JedS/openflight/session_logs/kld7_capture_20260329_095614.png

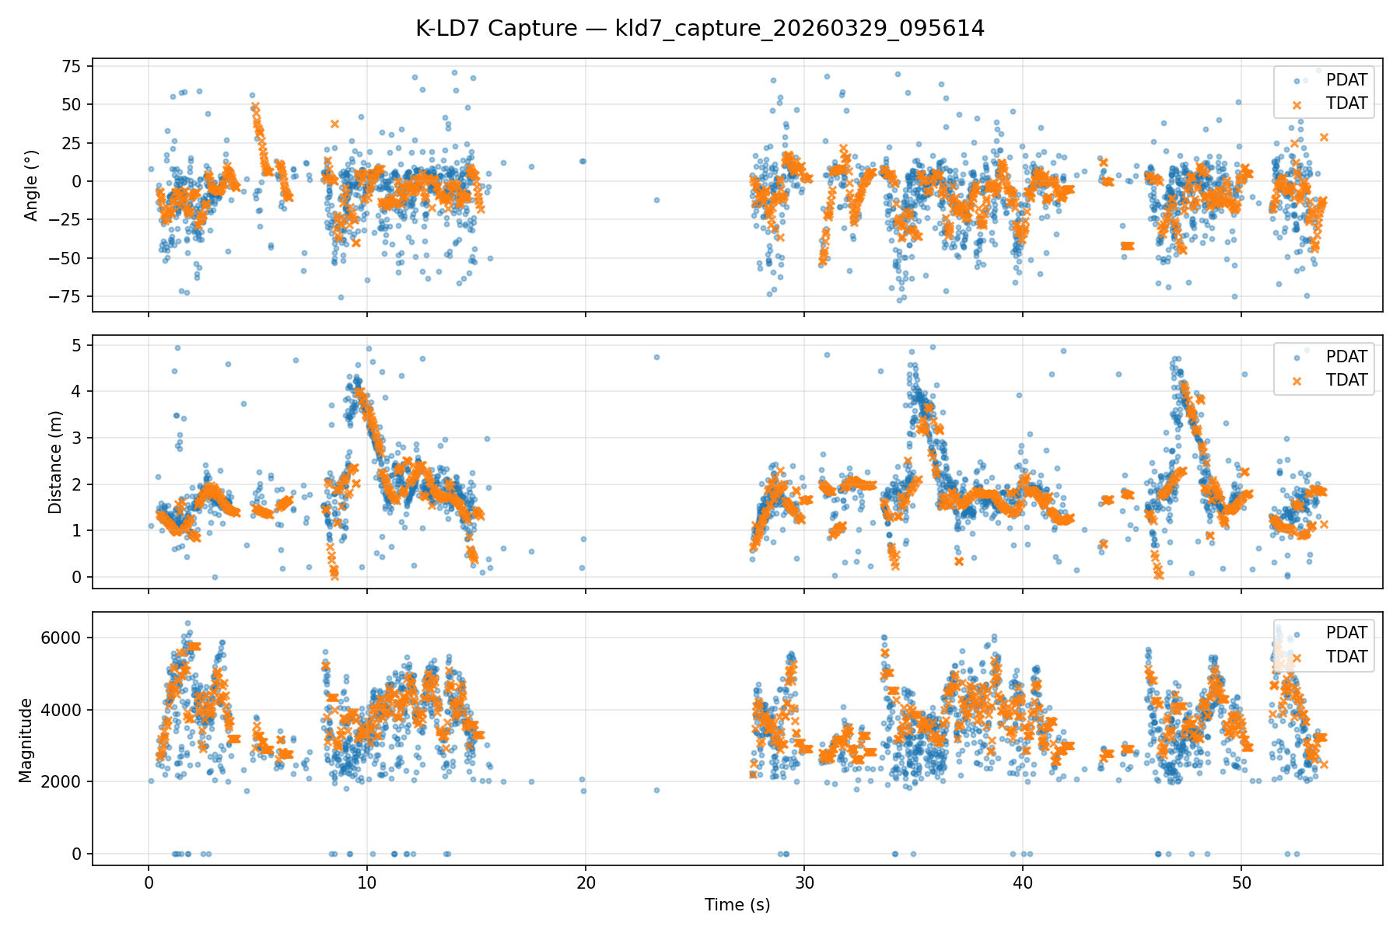
session_logs/kld7_capture_20260329_095614.png
