JedS/openflight/session_logs/kld7_capture_20260402_135117-wedge.png

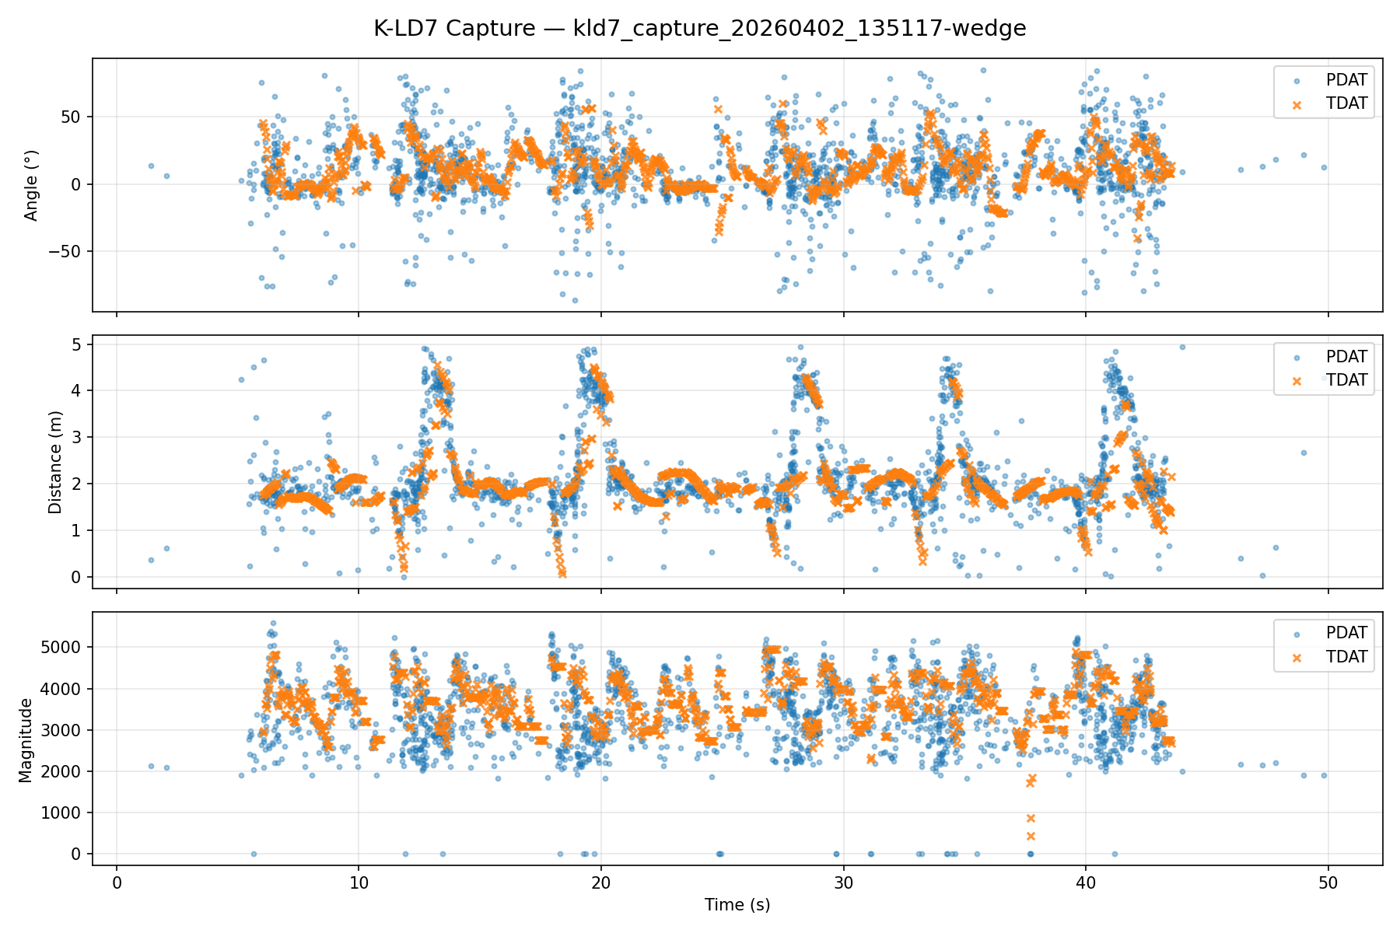
session_logs/kld7_capture_20260402_135117-wedge.png
