JedS/openflight/cad/IARC_case/stl/case_foot.stl

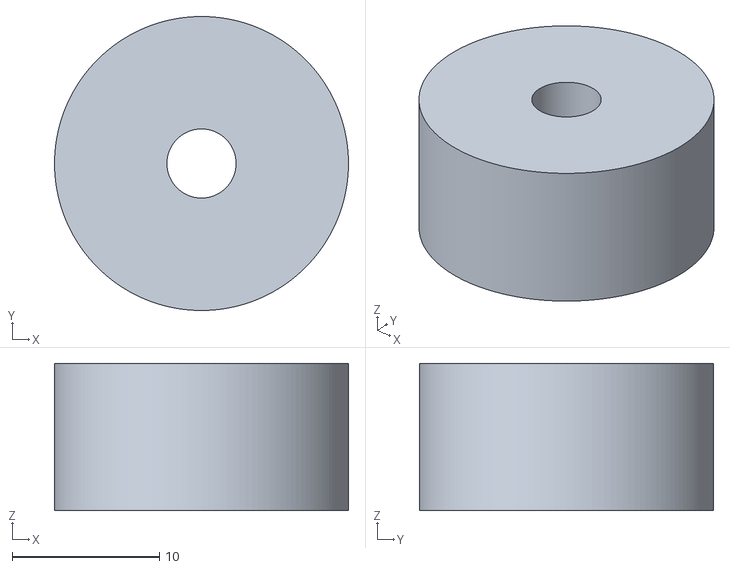
[picture p3: CAD file, 2026-04-02]
cad/IARC_case/stl/case_foot.stl
20.0 x 20.0 x 10.0
