JedS/openflight/OPS_mount.stl

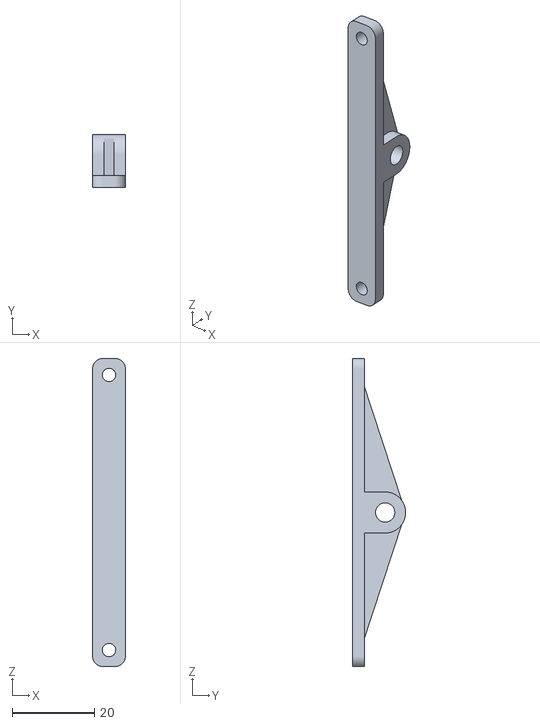
[picture p4: CAD file, 2026-04-02]
OPS_mount.stl
8.00 x 13.0 x 75.0
