JedS/openflight/cad/IARC_case/stl/outer_case_top.stl

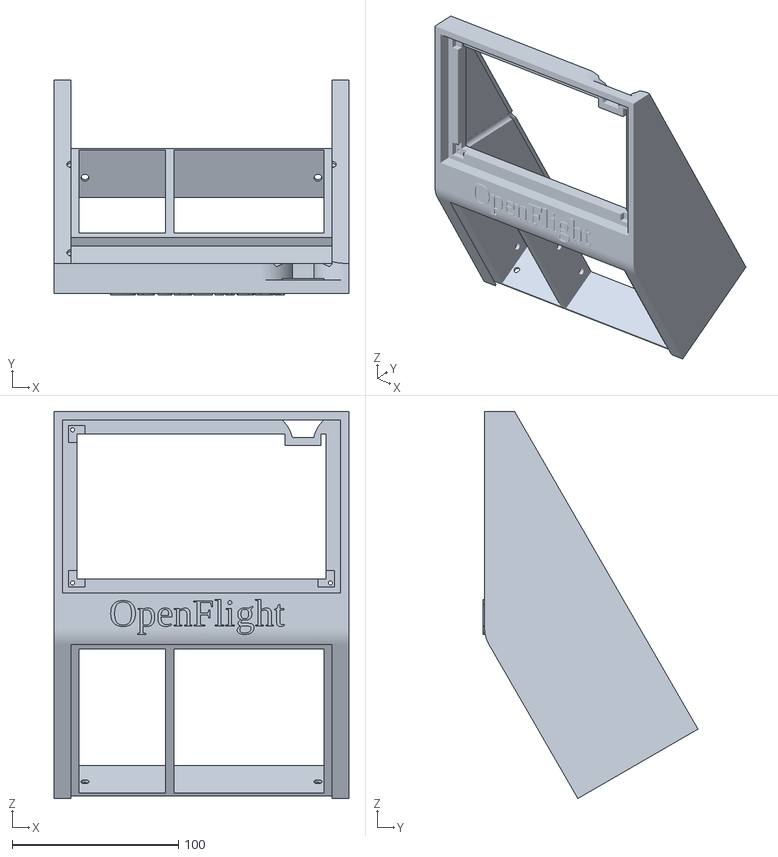
[picture p5: CAD file, 2026-04-02]
cad/IARC_case/stl/outer_case_top.stl
177.0 x 129.2 x 232.5
