JedS/openflight/KLD7_v_mount_R.stl

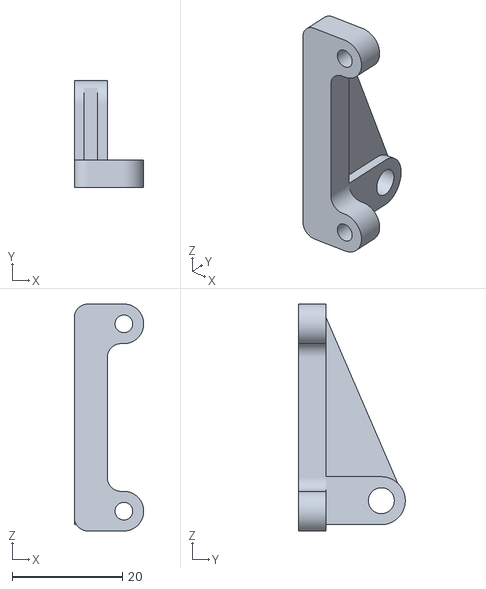
[picture p6: CAD file, 2026-04-02]
KLD7_v_mount_R.stl
12.6 x 19.3 x 41.2
