JedS/openflight/OpenFlight_case_proj.3mf

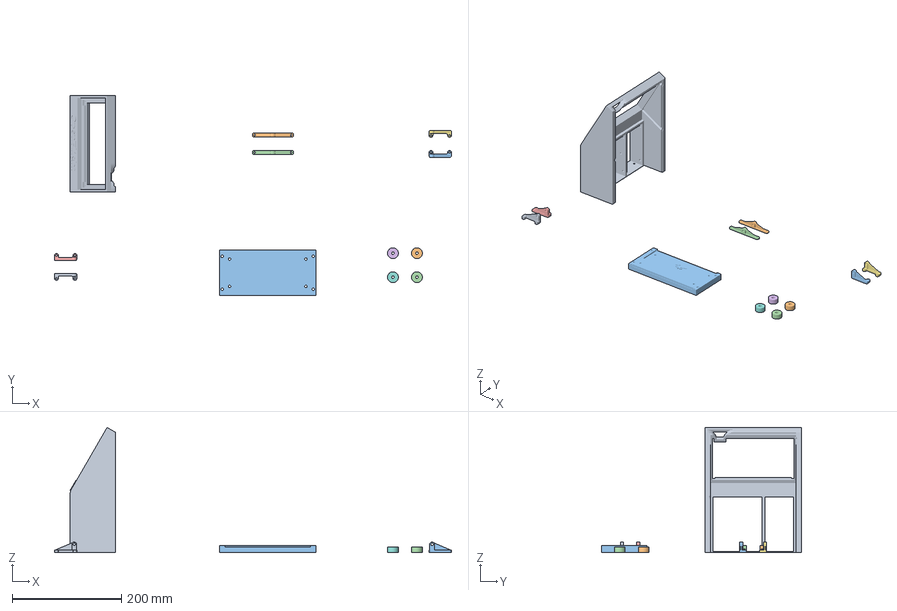
[picture p7: CAD file, 2026-04-02]
OpenFlight_case_proj.3mf
727.9 x 366.7 x 229.4 mm
outer_case_top.stl
case_foot.stl x 4
outer_case_bottom.stl
KLD7_h_mount_L.stl
KLD7_v_mount_L.stl
KLD7_h_mount_R.stl
OPS_mount.stl x 2
KLD7_v_mount_R.stl
