JedS/openflight/KLD7_h_mount_R.stl

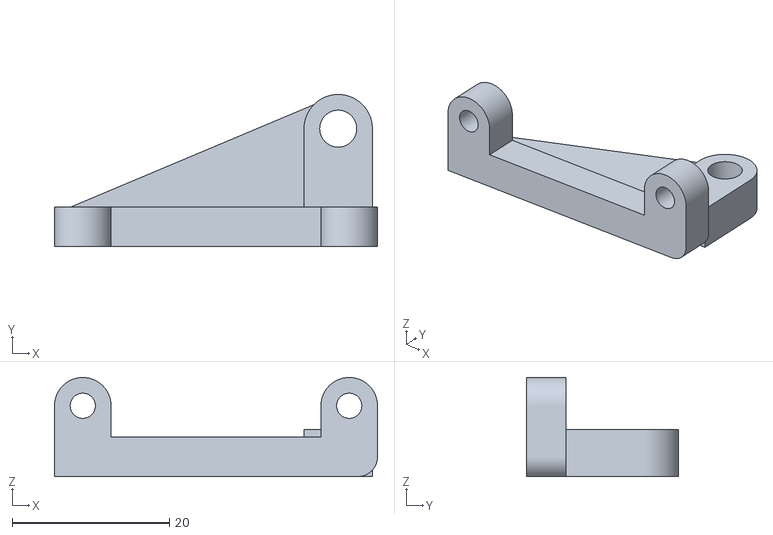
[picture p8: CAD file, 2026-04-02]
KLD7_h_mount_R.stl
41.1 x 19.4 x 12.6
