JedS/openflight/outer_case_bottom.stl

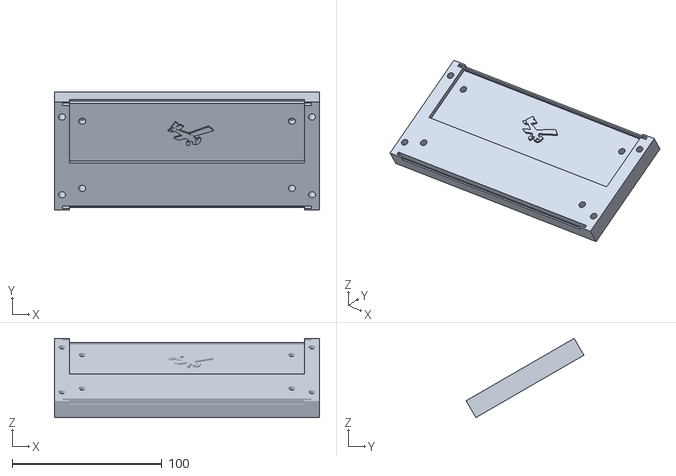
[picture p9: CAD file, 2026-04-02]
outer_case_bottom.stl
177.0 x 78.7 x 52.9
