JedS/openflight/(list of files, cad)

Other CAD files:
KLD7_v_mount_L.stl
KLD7_h_mount_L.stl
