JedS/openflight/README_case_build.pdf

M5 Bolts needed: 18
Front piece of glass size: 166mm wide x 115mm tall Back piece of glass size: 166mm wide x 225mm tall

Instructions for OpenFlight Case Build

1. Start by printing (1x) outer_case_top.stl. This part will house pretty much everything.

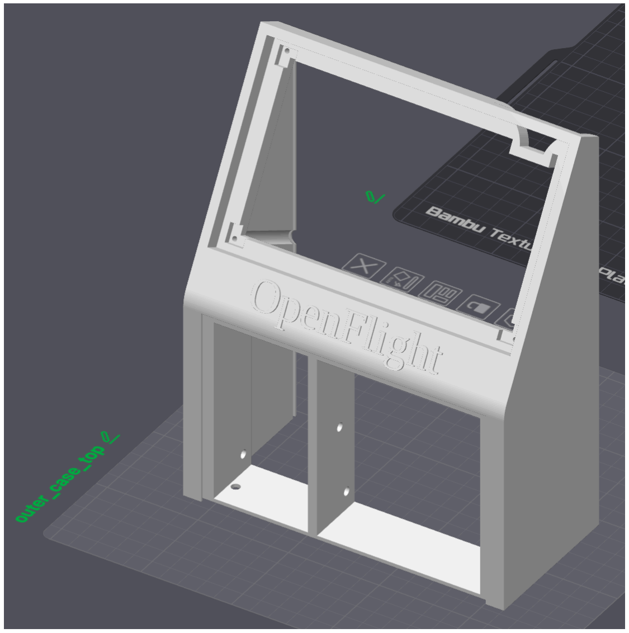
[picture p10: figure]

2. Print (2x) OPS_mount parts. These secure onto the OPS243 sensor.

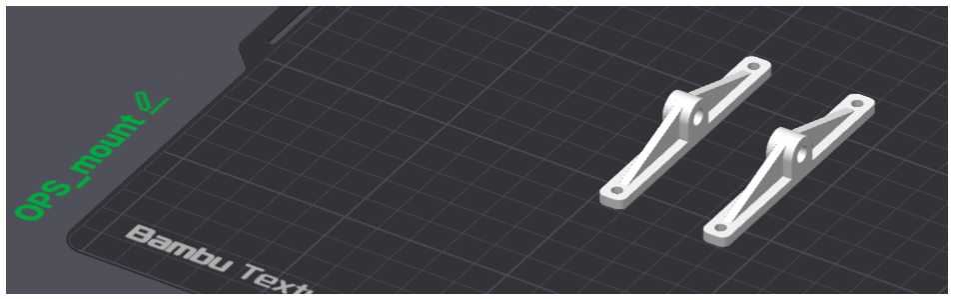
[picture p11: figure]

3. Once both mounts are secured to the OPS sensor, use (2x) M5 bolts to screw the entire OPS assembly into the larger left side of the outer_case_top part. Make sure the OPS assembly doesn’t protrude beyond the wall of the outer_case_top part. NOTE: I don’t know what screws are used for the OPS board itself…

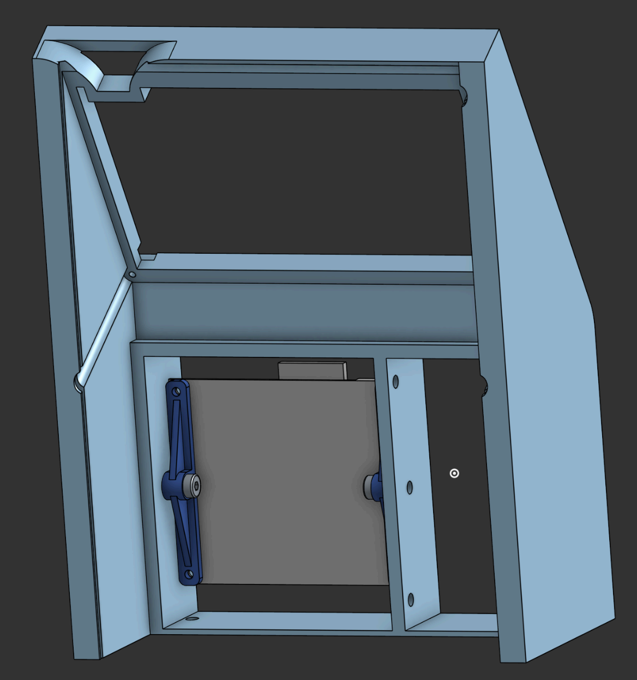
[picture p12: figure]

4. Print (1x) KLD7_v_mount_L.stl and (1x) KLD7_v_mount_R.stl. These will mount
to one of the KLD7 sensors, and secure it in the vertical position.

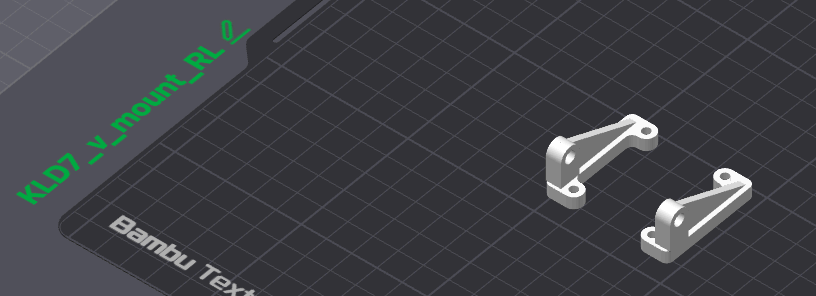
[picture p13: figure]

5. U

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
al K

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
bly in

t

o

t

h

e lo

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
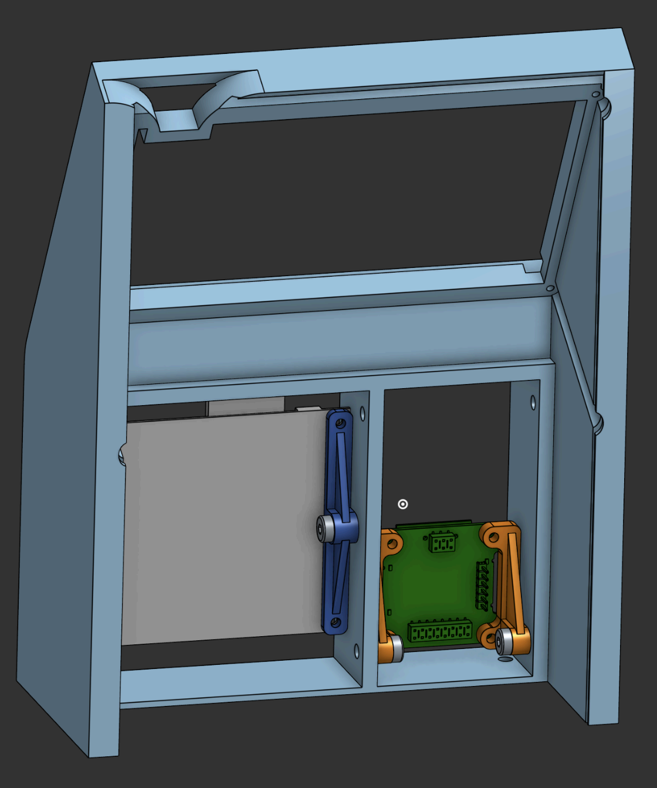
[picture p14: figure]

6. Print (1x) KLD7_h_mount_L.stl and (1x) KLD7_h_mount_R.stl. These will mount
to the other KLD7 sensor, and secure it in the horizontal position.

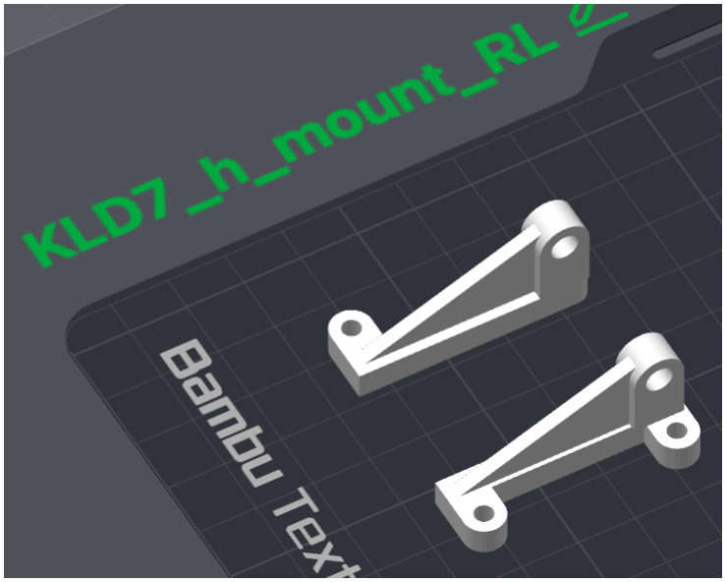
[picture p15: figure]

7. U

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
al K

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
bly in

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
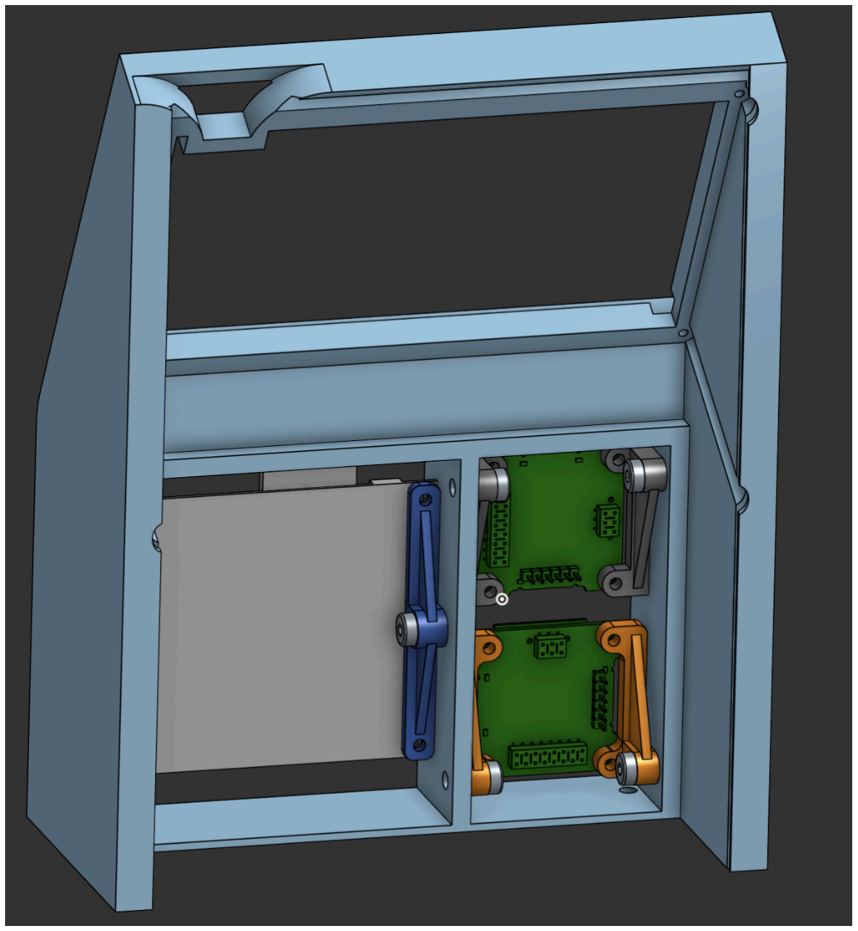
[picture p16: figure]
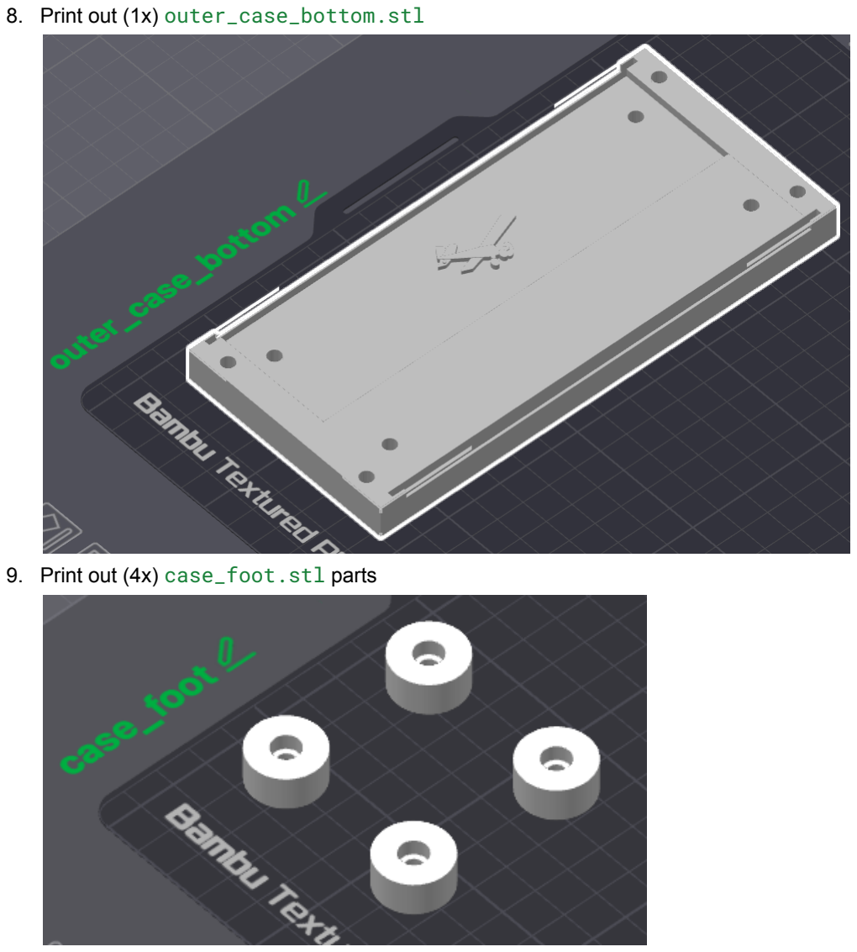
[picture p17: page 8]

8. Print out (1x) outer_case_bottom.stl
9. Print out (4x) case_foot.stl parts

10. Use (4x) M5 bolts to secure each case_foot part to the underside of the outer_case_bottom part.

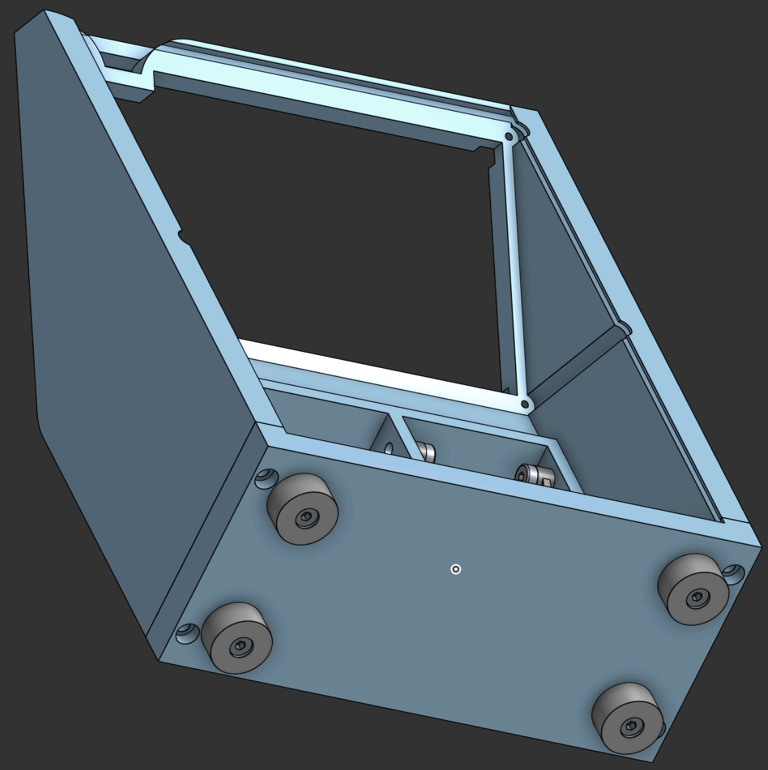
[picture p18: figure]

11. Use (4x) M5 bolts to secure the outer_case_bottom to the outer_case_t

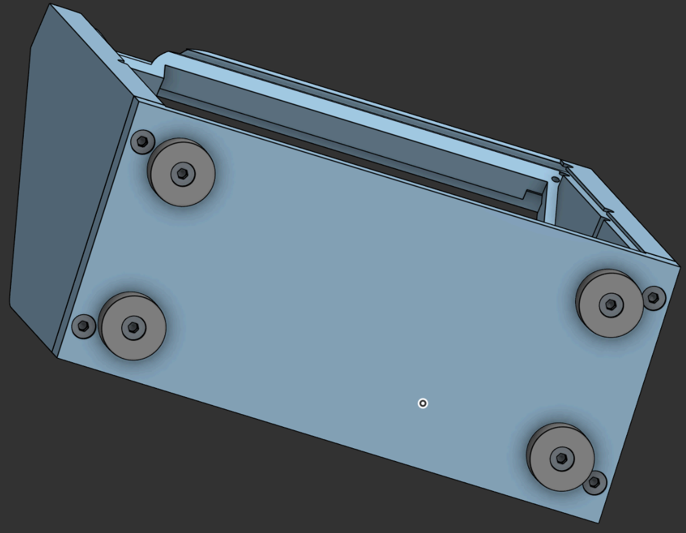
[picture p19: figure]

And that’s how you put together the 3d printed parts!
