JedS/openflight/tests/test_rolling_buffer.py

"""Tests for rolling_buffer module."""

import math
from datetime import datetime
from unittest.mock import MagicMock

import numpy as np
import pytest

from openflight.launch_monitor import ClubType, Shot
from openflight.rolling_buffer import (
    ImpactEstimate,
    IQCapture,
    ManualTrigger,
    PollingTrigger,
    ProcessedCapture,
    RollingBufferProcessor,
    SpeedReading,
    SpeedTimeline,
    SpinCandidate,
    SpinResult,
    ThresholdTrigger,
    create_trigger,
    # Monitor functions
    estimate_carry_with_spin,
    get_optimal_spin_for_ball_speed,
)

# =============================================================================
# Tests for Optimal Spin Calculation
# =============================================================================


class TestGetOptimalSpinForBallSpeed:
    """Tests for the optimal spin rate calculation based on ball speed."""

    def test_high_ball_speed_180_mph(self):
        """180 mph ball speed should have ~2050 rpm optimal spin."""
        optimal = get_optimal_spin_for_ball_speed(180, ClubType.DRIVER)
        assert 2000 <= optimal <= 2100

    def test_tour_average_167_mph(self):
        """167 mph (PGA Tour avg) should have ~2450 rpm optimal spin."""
        optimal = get_optimal_spin_for_ball_speed(167, ClubType.DRIVER)
        assert 2300 <= optimal <= 2600

    def test_moderate_speed_160_mph(self):
        """160 mph ball speed should have ~2550 rpm optimal spin."""
        optimal = get_optimal_spin_for_ball_speed(160, ClubType.DRIVER)
        assert 2500 <= optimal <= 2600

    def test_amateur_speed_140_mph(self):
        """140 mph ball speed should have ~2700 rpm optimal spin."""
        optimal = get_optimal_spin_for_ball_speed(140, ClubType.DRIVER)
        assert 2650 <= optimal <= 2750

    def test_slower_speed_120_mph(self):
        """120 mph ball speed should have ~2900 rpm optimal spin."""
        optimal = get_optimal_spin_for_ball_speed(120, ClubType.DRIVER)
        assert 2850 <= optimal <= 2950

    def test_very_slow_speed_100_mph(self):
        """100 mph ball speed should have ~3100 rpm optimal spin."""
        optimal = get_optimal_spin_for_ball_speed(100, ClubType.DRIVER)
        assert 3050 <= optimal <= 3150

    def test_optimal_spin_decreases_with_ball_speed(self):
        """Higher ball speeds should require less spin."""
        spin_120 = get_optimal_spin_for_ball_speed(120, ClubType.DRIVER)
        spin_140 = get_optimal_spin_for_ball_speed(140, ClubType.DRIVER)
        spin_160 = get_optimal_spin_for_ball_speed(160, ClubType.DRIVER)
        spin_180 = get_optimal_spin_for_ball_speed(180, ClubType.DRIVER)

        assert spin_120 > spin_140 > spin_160 > spin_180

    def test_irons_need_more_spin_than_driver(self):
        """Irons should have higher optimal spin than driver at same speed."""
        driver_spin = get_optimal_spin_for_ball_speed(140, ClubType.DRIVER)
        iron_7_spin = get_optimal_spin_for_ball_speed(140, ClubType.IRON_7)
        pw_spin = get_optimal_spin_for_ball_speed(140, ClubType.PW)

        assert iron_7_spin > driver_spin
        assert pw_spin > iron_7_spin

    def test_club_spin_ordering(self):
        """Shorter clubs should require more spin."""
        ball_speed = 130
        driver = get_optimal_spin_for_ball_speed(ball_speed, ClubType.DRIVER)
        wood_3 = get_optimal_spin_for_ball_speed(ball_speed, ClubType.WOOD_3)
        iron_5 = get_optimal_spin_for_ball_speed(ball_speed, ClubType.IRON_5)
        iron_9 = get_optimal_spin_for_ball_speed(ball_speed, ClubType.IRON_9)
        pw = get_optimal_spin_for_ball_speed(ball_speed, ClubType.PW)

        assert driver < wood_3 < iron_5 < iron_9 < pw


# =============================================================================
# Tests for Carry Distance with Spin
# =============================================================================


class TestEstimateCarryWithSpin:
    """Tests for the spin-adjusted carry distance calculation."""

    def test_optimal_spin_gives_best_carry(self):
        """Spin at optimal rate should give highest carry."""
        ball_speed = 160
        optimal_spin = get_optimal_spin_for_ball_speed(ball_speed, ClubType.DRIVER)

        carry_optimal = estimate_carry_with_spin(ball_speed, optimal_spin, ClubType.DRIVER)
        carry_low = estimate_carry_with_spin(ball_speed, optimal_spin - 1000, ClubType.DRIVER)
        carry_high = estimate_carry_with_spin(ball_speed, optimal_spin + 1000, ClubType.DRIVER)

        assert carry_optimal >= carry_low
        assert carry_optimal >= carry_high

    def test_low_spin_penalty_more_severe_than_high_spin(self):
        """Low spin should hurt carry more than high spin."""
        ball_speed = 160
        optimal_spin = get_optimal_spin_for_ball_speed(ball_speed, ClubType.DRIVER)

        carry_optimal = estimate_carry_with_spin(ball_speed, optimal_spin, ClubType.DRIVER)
        carry_1000_low = estimate_carry_with_spin(ball_speed, optimal_spin - 1000, ClubType.DRIVER)
        carry_1000_high = estimate_carry_with_spin(ball_speed, optimal_spin + 1000, ClubType.DRIVER)

        low_penalty = carry_optimal - carry_1000_low
        high_penalty = carry_optimal - carry_1000_high

        # Low spin penalty should be larger
        assert low_penalty > high_penalty

    def test_tour_average_produces_expected_carry(self):
        """167 mph with ~2686 rpm should produce ~275 yards (Tour avg)."""
        carry = estimate_carry_with_spin(167, 2686, ClubType.DRIVER)
        # Allow some tolerance since we don't have launch angle
        assert 260 <= carry <= 290

    def test_very_low_spin_significant_penalty(self):
        """Very low spin (1500 rpm at 160 mph) should lose significant distance."""
        carry_optimal = estimate_carry_with_spin(160, 2550, ClubType.DRIVER)
        carry_low_spin = estimate_carry_with_spin(160, 1500, ClubType.DRIVER)

        # Should lose at least 10% carry
        assert carry_low_spin < carry_optimal * 0.90

    def test_very_high_spin_moderate_penalty(self):
        """Very high spin (4500 rpm at 160 mph) should lose moderate distance."""
        carry_optimal = estimate_carry_with_spin(160, 2550, ClubType.DRIVER)
        carry_high_spin = estimate_carry_with_spin(160, 4500, ClubType.DRIVER)

        # Should lose some but not as much as low spin
        assert carry_high_spin < carry_optimal
        assert carry_high_spin > carry_optimal * 0.85

    def test_smash_factor_penalty_for_poor_contact(self):
        """Poor smash factor should reduce carry estimate."""
        ball_speed = 150
        spin = 2600

        # Good contact: 150 mph ball / 100 mph club = 1.50 smash
        carry_good = estimate_carry_with_spin(ball_speed, spin, ClubType.DRIVER, club_speed_mph=100)

        # Poor contact: 150 mph ball / 115 mph club = 1.30 smash
        carry_poor = estimate_carry_with_spin(ball_speed, spin, ClubType.DRIVER, club_speed_mph=115)

        assert carry_poor < carry_good

    def test_no_club_speed_no_smash_penalty(self):
        """Without club speed, no smash factor penalty applied."""
        ball_speed = 150
        spin = 2600

        carry_no_club = estimate_carry_with_spin(ball_speed, spin, ClubType.DRIVER)
        carry_with_club = estimate_carry_with_spin(
            ball_speed,
            spin,
            ClubType.DRIVER,
            club_speed_mph=101,  # 1.48 smash - optimal
        )

        # Should be very close (club speed at optimal smash has minimal effect)
        assert abs(carry_no_club - carry_with_club) < 5

    def test_carry_increases_with_ball_speed(self):
        """Higher ball speed should always increase carry."""
        spin = 2600
        carry_120 = estimate_carry_with_spin(120, spin, ClubType.DRIVER)
        carry_140 = estimate_carry_with_spin(140, spin, ClubType.DRIVER)
        carry_160 = estimate_carry_with_spin(160, spin, ClubType.DRIVER)

        assert carry_120 < carry_140 < carry_160

    def test_realistic_carry_values(self):
        """Test that carry values are in realistic ranges."""
        # Amateur golfer: 140 mph ball speed, 2800 rpm
        amateur = estimate_carry_with_spin(140, 2800, ClubType.DRIVER)
        assert 220 <= amateur <= 250

        # Tour player: 170 mph ball speed, 2400 rpm
        tour = estimate_carry_with_spin(170, 2400, ClubType.DRIVER)
        assert 280 <= tour <= 320  # Widened range for slightly above optimal

        # Long drive: 190 mph ball speed, 2000 rpm
        long_drive = estimate_carry_with_spin(190, 2000, ClubType.DRIVER)
        assert 330 <= long_drive <= 380  # Widened for variation


# =============================================================================
# Tests for Rolling Buffer Types
# =============================================================================


class TestIQCapture:
    """Tests for IQCapture dataclass."""

    def test_create_iq_capture(self):
        """Basic IQCapture creation."""
        i_samples = [100] * 4096
        q_samples = [100] * 4096
        capture = IQCapture(
            sample_time=0.136,
            trigger_time=0.0,
            i_samples=i_samples,
            q_samples=q_samples,
            timestamp=1234567890.0,
        )
        assert capture.sample_time == 0.136
        assert len(capture.i_samples) == 4096
        assert len(capture.q_samples) == 4096


class TestSpeedReading:
    """Tests for rolling buffer SpeedReading dataclass."""

    def test_create_speed_reading(self):
        """Basic SpeedReading creation."""
        reading = SpeedReading(
            speed_mph=155.3,
            timestamp_ms=50.0,
            magnitude=500.0,
            direction="outbound",
        )
        assert reading.speed_mph == 155.3
        assert reading.is_outbound is True

    def test_inbound_direction(self):
        """Test inbound direction detection."""
        reading = SpeedReading(
            speed_mph=50.0,
            timestamp_ms=10.0,
            magnitude=100.0,
            direction="inbound",
        )
        assert reading.is_outbound is False


class TestSpeedTimeline:
    """Tests for SpeedTimeline dataclass."""

    def test_peak_speed(self):
        """Peak speed should return highest reading."""
        readings = [
            SpeedReading(speed_mph=100.0, timestamp_ms=10.0, magnitude=100, direction="outbound"),
            SpeedReading(speed_mph=155.0, timestamp_ms=20.0, magnitude=200, direction="outbound"),
            SpeedReading(speed_mph=120.0, timestamp_ms=30.0, magnitude=150, direction="outbound"),
        ]
        timeline = SpeedTimeline(readings=readings, sample_rate_hz=937.5)

        assert timeline.peak_speed is not None
        assert timeline.peak_speed.speed_mph == 155.0

    def test_speeds_property(self):
        """speeds property should return list of speed values."""
        readings = [
            SpeedReading(speed_mph=100.0, timestamp_ms=10.0, magnitude=100, direction="outbound"),
            SpeedReading(speed_mph=150.0, timestamp_ms=20.0, magnitude=200, direction="outbound"),
        ]
        timeline = SpeedTimeline(readings=readings, sample_rate_hz=937.5)

        assert timeline.speeds == [100.0, 150.0]

    def test_duration_ms(self):
        """Duration should be difference between first and last timestamp."""
        readings = [
            SpeedReading(speed_mph=100.0, timestamp_ms=10.0, magnitude=100, direction="outbound"),
            SpeedReading(speed_mph=150.0, timestamp_ms=60.0, magnitude=200, direction="outbound"),
        ]
        timeline = SpeedTimeline(readings=readings, sample_rate_hz=937.5)

        assert timeline.duration_ms == 50.0


class TestSpinResult:
    """Tests for SpinResult dataclass."""

    def test_quality_high(self):
        """High confidence should produce 'high' quality."""
        result = SpinResult(
            spin_rpm=2800,
            confidence=0.85,
            snr=5.0,
            quality="high",
        )
        assert result.quality == "high"

    def test_quality_low(self):
        """Low confidence should produce 'low' quality."""
        result = SpinResult(
            spin_rpm=2800,
            confidence=0.3,
            snr=2.0,
            quality="low",
        )
        assert result.quality == "low"

    def test_no_spin_detected_preserves_snr(self):
        """Rejected spin should keep the measured SNR for diagnostics."""
        result = SpinResult.no_spin_detected(
            "SNR too low",
            snr=2.96,
            peak_freq_hz=95.21484375,
            seam_cycles=4.8,
        )
        assert result.spin_rpm == 0
        assert result.snr == pytest.approx(2.96)
        assert result.peak_freq_hz == pytest.approx(95.21484375)
        assert result.rejection_reason == "SNR too low"

    def test_spin_candidate_serializes_for_logs(self):
        """Spin candidates should be JSON-friendly and rounded."""
        candidate = SpinCandidate(
            rank=1,
            rpm=5493.16,
            freq_hz=91.552734375,
            relative_magnitude=0.4567,
            snr=3.214,
            expected_spin_error_pct=8.765,
            selected=True,
        )

        assert candidate.to_dict() == {
            "rank": 1,
            "rpm": 5493,
            "freq_hz": 91.553,
            "relative_magnitude": 0.457,
            "snr": 3.21,
            "at_lower_rail": False,
            "at_upper_rail": False,
            "expected_spin_error_pct": 8.8,
            "selected": True,
        }


# =============================================================================
# Tests for Rolling Buffer Processor
# =============================================================================


class TestRollingBufferProcessor:
    """Tests for the FFT-based rolling buffer processor."""

    @pytest.fixture
    def processor(self):
        """Create a processor instance for testing."""
        return RollingBufferProcessor()

    def test_processor_creation(self):
        """Processor should initialize with correct constants."""
        processor = RollingBufferProcessor()
        assert processor.WINDOW_SIZE == 128
        assert processor.FFT_SIZE == 4096
        assert processor.SAMPLE_RATE == 30000

    def test_parse_capture_valid_json(self, processor):
        """Parser should handle valid JSON response."""
        # Create a mock JSON response like the radar would return
        # The radar sends each field as a separate JSON line
        i_samples = [2048 + int(100 * math.sin(2 * math.pi * i / 128)) for i in range(4096)]
        q_samples = [2048 + int(100 * math.cos(2 * math.pi * i / 128)) for i in range(4096)]

        import json

        response = (
            '{"sample_time": 0.136}\n'
            '{"trigger_time": 0.0}\n'
            f'{{"I": {json.dumps(i_samples)}}}\n'
            f'{{"Q": {json.dumps(q_samples)}}}'
        )

        capture = processor.parse_capture(response)

        assert capture is not None
        assert len(capture.i_samples) == 4096
        assert len(capture.q_samples) == 4096
        assert capture.sample_time == 0.136
        assert capture.trigger_time == 0.0

    def test_parse_capture_records_first_byte_timestamp(self, processor):
        """Parser should preserve first-byte time and infer trigger epoch."""
        i_samples = [2048] * 4096
        q_samples = [2048] * 4096

        import json

        response = (
            '{"sample_time": 100.0}\n'
            '{"trigger_time": 100.068}\n'
            f'{{"I": {json.dumps(i_samples)}}}\n'
            f'{{"Q": {json.dumps(q_samples)}}}'
        )

        capture = processor.parse_capture(response, first_byte_timestamp=12345.678)

        assert capture is not None
        assert capture.first_byte_timestamp == pytest.approx(12345.678)
        expected_post_trigger_s = (capture.duration_ms - capture.trigger_offset_ms) / 1000.0
        assert capture.trigger_timestamp == pytest.approx(12345.678 - expected_post_trigger_s)

    def test_parse_capture_invalid_json(self, processor):
        """Parser should handle invalid JSON gracefully."""
        capture = processor.parse_capture("not valid json")
        assert capture is None

    def test_parse_capture_missing_fields(self, processor):
        """Parser should handle missing fields."""
        capture = processor.parse_capture('{"sample_time":0.136}')
        assert capture is None

    def test_process_standard_returns_timeline(self, processor):
        """Standard processing should return a SpeedTimeline."""
        # Use a Doppler frequency above DC_MASK_BINS (150 bins ≈ 15 mph).
        # 1500 Hz → bin ~205 → ~20.9 mph, safely above the mask.
        # I=sin, Q=cos produces a negative-frequency (inbound) tone.
        doppler_freq = 1500  # Hz - corresponds to ~20.9 mph
        i_samples = [
            2048 + int(500 * math.sin(2 * math.pi * doppler_freq * i / 30000)) for i in range(4096)
        ]
        q_samples = [
            2048 + int(500 * math.cos(2 * math.pi * doppler_freq * i / 30000)) for i in range(4096)
        ]

        capture = IQCapture(
            sample_time=0.136,
            trigger_time=0.0,
            i_samples=i_samples,
            q_samples=q_samples,
            timestamp=1234567890.0,
        )

        timeline = processor.process_standard(capture)

        assert timeline is not None
        assert isinstance(timeline, SpeedTimeline)
        # With 4096 samples and 128 block size, we get 4096/128 = 32 readings
        assert len(timeline.readings) == 32

    def test_process_overlapping_higher_resolution(self, processor):
        """Overlapping processing should give more readings than standard."""
        doppler_freq = 1500  # Hz - ~20.9 mph, above DC mask
        i_samples = [
            2048 + int(500 * math.sin(2 * math.pi * doppler_freq * i / 30000)) for i in range(4096)
        ]
        q_samples = [
            2048 + int(500 * math.cos(2 * math.pi * doppler_freq * i / 30000)) for i in range(4096)
        ]

        capture = IQCapture(
            sample_time=0.136,
            trigger_time=0.0,
            i_samples=i_samples,
            q_samples=q_samples,
            timestamp=1234567890.0,
        )

        standard = processor.process_standard(capture)
        overlapping = processor.process_overlapping(capture)

        # Standard: 4096/128 = 32 readings
        # Overlapping: (4096-128)/32 + 1 = 125 readings (4x more)
        assert len(overlapping.readings) > len(standard.readings)
        assert len(standard.readings) == 32
        assert len(overlapping.readings) >= 120  # Allow some tolerance


# =============================================================================
# Tests for Trigger Strategies
# =============================================================================


class TestTriggerFactory:
    """Tests for the trigger factory function."""

    def test_create_polling_trigger(self):
        """Factory should create PollingTrigger."""
        trigger = create_trigger("polling")
        assert isinstance(trigger, PollingTrigger)

    def test_create_threshold_trigger(self):
        """Factory should create ThresholdTrigger."""
        trigger = create_trigger("threshold", speed_threshold_mph=60)
        assert isinstance(trigger, ThresholdTrigger)

    def test_create_manual_trigger(self):
        """Factory should create ManualTrigger."""
        trigger = create_trigger("manual")
        assert isinstance(trigger, ManualTrigger)

    def test_invalid_trigger_type(self):
        """Factory should raise error for unknown trigger type."""
        with pytest.raises(ValueError):
            create_trigger("invalid_type")


class TestSoundTriggerTimestampPropagation:
    """Tests for hardware trigger timestamp propagation."""

    def test_ops_hardware_trigger_records_first_byte_timestamp(self):
        """OPS hardware wait should expose when the first serial byte arrived."""
        from openflight.ops243 import OPS243Radar

        class FakeSerial:
            is_open = True

            def __init__(self):
                self._response = b'{"Q": [1]}'

            @property
            def in_waiting(self):
                return len(self._response)

            def reset_input_buffer(self):
                pass

            def read(self, byte_count):
                chunk = self._response[:byte_count]
                self._response = self._response[byte_count:]
                return chunk

        radar = OPS243Radar(port="/dev/null")
        radar.serial = FakeSerial()

        response = radar.wait_for_hardware_trigger(timeout=1.0)

        assert response == '{"Q": [1]}'
        assert radar.last_hardware_trigger_first_byte_timestamp is not None

    def test_sound_trigger_uses_buffer_offset_for_trigger_timestamp(self):
        """Hardware captures should translate first-byte time back to trigger time."""
        from openflight.rolling_buffer.trigger import SoundTrigger

        radar = MagicMock()
        radar.wait_for_hardware_trigger.return_value = '{"sample_time": 0.0}'
        radar.last_hardware_trigger_first_byte_timestamp = 12345.678

        capture = IQCapture(
            sample_time=100.000,
            trigger_time=100.068,
            i_samples=[2048] * 4096,
            q_samples=[2048] * 4096,
        )
        processor = MagicMock()
        processor.parse_capture.return_value = capture
        processor.process_standard.return_value = SpeedTimeline(
            readings=[
                SpeedReading(
                    speed_mph=100.0,
                    magnitude=1000.0,
                    timestamp_ms=68.0,
                    direction="outbound",
                )
            ],
            sample_rate_hz=937.5,
        )

        trigger = SoundTrigger(pre_trigger_segments=12)
        result = trigger.wait_for_trigger(radar, processor, timeout=1.0)

        assert result is capture
        assert result.first_byte_timestamp == pytest.approx(12345.678)
        expected_post_trigger_s = (capture.duration_ms - capture.trigger_offset_ms) / 1000.0
        assert result.trigger_timestamp == pytest.approx(12345.678 - expected_post_trigger_s)
        processor.parse_capture.assert_called_once_with(
            '{"sample_time": 0.0}',
            first_byte_timestamp=12345.678,
        )
        radar.rearm_rolling_buffer.assert_called_once_with(12)

    def test_sound_trigger_prefers_ops_clock_sync_for_trigger_timestamp(self):
        """Radar-clock trigger time should beat first-byte timing when available."""
        from openflight.rolling_buffer.trigger import SoundTrigger

        radar = MagicMock()
        radar.wait_for_hardware_trigger.return_value = '{"sample_time": 0.0}'
        radar.last_hardware_trigger_first_byte_timestamp = 12345.678
        radar.last_clock_sync = {"best_offset_s": 12000.0}

        capture = IQCapture(
            sample_time=100.000,
            trigger_time=100.068,
            i_samples=[2048] * 4096,
            q_samples=[2048] * 4096,
        )
        processor = MagicMock()
        processor.parse_capture.return_value = capture
        processor.process_standard.return_value = SpeedTimeline(
            readings=[
                SpeedReading(
                    speed_mph=100.0,
                    magnitude=1000.0,
                    timestamp_ms=68.0,
                    direction="outbound",
                )
            ],
            sample_rate_hz=937.5,
        )

        trigger = SoundTrigger(pre_trigger_segments=12)
        result = trigger.wait_for_trigger(radar, processor, timeout=1.0)

        assert result is capture
        assert result.trigger_timestamp == pytest.approx(12100.068)
        assert result.trigger_timestamp_source == "ops_clock_sync"


class TestPollingTrigger:
    """Tests for the polling-based trigger."""

    def test_default_parameters(self):
        """Polling trigger should have sensible defaults."""
        trigger = PollingTrigger()
        assert trigger.poll_interval == 0.3
        assert trigger.min_readings == 1
        assert trigger.min_speed_mph == 15

    def test_custom_parameters(self):
        """Polling trigger should accept custom parameters."""
        trigger = PollingTrigger(
            poll_interval=0.2,
            min_readings=5,
            min_speed_mph=50,
        )
        assert trigger.poll_interval == 0.2
        assert trigger.min_readings == 5
        assert trigger.min_speed_mph == 50

    def test_reset_no_state(self):
        """Polling trigger reset should be no-op."""
        trigger = PollingTrigger()
        trigger.reset()  # Should not raise


class TestThresholdTrigger:
    """Tests for the threshold-based trigger."""

    def test_default_threshold(self):
        """Threshold trigger should have default 50 mph threshold."""
        trigger = ThresholdTrigger()
        assert trigger.speed_threshold_mph == 50

    def test_custom_threshold(self):
        """Threshold trigger should accept custom threshold."""
        trigger = ThresholdTrigger(speed_threshold_mph=70)
        assert trigger.speed_threshold_mph == 70

    def test_reset_clears_triggered(self):
        """Reset should clear triggered state."""
        trigger = ThresholdTrigger()
        trigger._triggered = True
        trigger.reset()
        assert trigger._triggered is False


class TestManualTrigger:
    """Tests for the manual trigger."""

    def test_initial_state(self):
        """Manual trigger should start with no request."""
        trigger = ManualTrigger()
        assert trigger._trigger_requested is False

    def test_request_trigger(self):
        """Request should set trigger flag."""
        trigger = ManualTrigger()
        trigger.request_trigger()
        assert trigger._trigger_requested is True

    def test_reset_clears_request(self):
        """Reset should clear trigger request."""
        trigger = ManualTrigger()
        trigger.request_trigger()
        trigger.reset()
        assert trigger._trigger_requested is False


# =============================================================================
# Tests for Shot with Spin Fields
# =============================================================================


class TestShotWithSpin:
    """Tests for Shot dataclass spin-related fields."""

    def test_shot_with_spin_data(self):
        """Shot should accept spin fields."""
        shot = Shot(
            ball_speed_mph=160.0,
            timestamp=datetime.now(),
            club_speed_mph=108.0,
            spin_rpm=2550.0,
            spin_confidence=0.85,
            carry_spin_adjusted=275.0,
        )
        assert shot.spin_rpm == 2550.0
        assert shot.spin_confidence == 0.85
        assert shot.carry_spin_adjusted == 275.0

    def test_shot_without_spin_data(self):
        """Shot should work without spin fields."""
        shot = Shot(
            ball_speed_mph=160.0,
            timestamp=datetime.now(),
        )
        assert shot.spin_rpm is None
        assert shot.spin_confidence is None
        assert shot.carry_spin_adjusted is None

    def test_has_spin_property(self):
        """has_spin should return True when spin_rpm is set."""
        shot_with_spin = Shot(
            ball_speed_mph=160.0,
            timestamp=datetime.now(),
            spin_rpm=2550.0,
        )
        shot_without_spin = Shot(
            ball_speed_mph=160.0,
            timestamp=datetime.now(),
        )

        assert shot_with_spin.has_spin is True
        assert shot_without_spin.has_spin is False

    def test_spin_quality_high(self):
        """High confidence should return 'high' quality."""
        shot = Shot(
            ball_speed_mph=160.0,
            timestamp=datetime.now(),
            spin_rpm=2550.0,
            spin_confidence=0.8,
        )
        assert shot.spin_quality == "high"

    def test_spin_quality_medium(self):
        """Medium confidence should return 'medium' quality."""
        shot = Shot(
            ball_speed_mph=160.0,
            timestamp=datetime.now(),
            spin_rpm=2550.0,
            spin_confidence=0.5,
        )
        assert shot.spin_quality == "medium"

    def test_spin_quality_low(self):
        """Low confidence should return 'low' quality."""
        shot = Shot(
            ball_speed_mph=160.0,
            timestamp=datetime.now(),
            spin_rpm=2550.0,
            spin_confidence=0.3,
        )
        assert shot.spin_quality == "low"

    def test_spin_quality_none_without_confidence(self):
        """No confidence should return None quality."""
        shot = Shot(
            ball_speed_mph=160.0,
            timestamp=datetime.now(),
        )
        assert shot.spin_quality is None

    def test_spin_quality_preserves_processor_label(self):
        """Shot quality should use the processor label when available."""
        shot = Shot(
            ball_speed_mph=160.0,
            timestamp=datetime.now(),
            spin_rpm=5054.0,
            spin_confidence=0.5,
            spin_result_quality="low",
        )
        assert shot.spin_quality == "low"

    def test_shot_accepts_rejected_spin_diagnostics(self):
        """Rejected spin diagnostics should be representable on a shot."""
        shot = Shot(
            ball_speed_mph=120.0,
            timestamp=datetime.now(),
            spin_snr=2.96,
            spin_peak_freq_hz=95.21484375,
            spin_seam_cycles=4.8,
            spin_rejection_reason="SNR too low (2.96, need 3.0)",
        )
        assert shot.spin_rpm is None
        assert shot.spin_snr == pytest.approx(2.96)
        assert shot.spin_peak_freq_hz == pytest.approx(95.21484375)
        assert shot.spin_rejection_reason == "SNR too low (2.96, need 3.0)"


# =============================================================================
# Tests for monitor spin plausibility
# =============================================================================


class TestRollingBufferMonitorSpinPlausibility:
    """Tests for club-aware filtering of spin artifacts."""

    def _processed_with_spin(self, spin: SpinResult) -> ProcessedCapture:
        capture = IQCapture(
            sample_time=0.0,
            trigger_time=0.068,
            i_samples=[2048] * 4096,
            q_samples=[2048] * 4096,
            first_byte_timestamp=12345.746,
            trigger_timestamp=12345.678,
        )
        return ProcessedCapture(
            timeline=SpeedTimeline(readings=[], sample_rate_hz=937.5),
            ball_speed_mph=100.0,
            ball_timestamp_ms=60.0,
            club_speed_mph=75.0,
            spin=spin,
            capture=capture,
        )

    def test_lower_rail_spin_withheld_for_high_spin_club(self):
        """PW/short-iron rail-low spin should be logged but not exposed."""
        from openflight.rolling_buffer import RollingBufferMonitor

        monitor = RollingBufferMonitor(port=None, trigger_type="manual")
        monitor.set_club(ClubType.PW)
        processed = self._processed_with_spin(
            SpinResult(
                spin_rpm=3296,
                confidence=0.8,
                snr=12.99,
                quality="high",
                peak_freq_hz=54.931640625,
                seam_cycles=3.9,
                at_lower_rail=True,
            )
        )

        shot = monitor._create_shot(processed)

        assert shot is not None
        assert shot.spin_rpm is None
        assert shot.spin_snr == pytest.approx(12.99)
        assert shot.spin_rejection_reason is not None
        assert "plausibility floor" in shot.spin_rejection_reason
        assert shot.impact_timestamp == pytest.approx(12345.678)

    def test_kld7_impact_timestamp_uses_hardware_trigger_timestamp(self):
        """K-LD7 geometry should use the trusted sound-trigger impact time."""
        from openflight.rolling_buffer import RollingBufferMonitor

        monitor = RollingBufferMonitor(port=None, trigger_type="manual")
        processed = self._processed_with_spin(
            SpinResult(spin_rpm=0, confidence=0.0, snr=0.0, quality="none")
        )

        shot = monitor._create_shot(processed)

        assert shot is not None
        assert shot.impact_timestamp == pytest.approx(12345.678)
        assert shot.impact_timestamp_kld7 == pytest.approx(12345.678)

    def test_lower_rail_driver_spin_kept_diagnostic_only(self):
        """Rail picks should be logged but not exposed as measured spin."""
        from openflight.rolling_buffer import RollingBufferMonitor

        monitor = RollingBufferMonitor(port=None, trigger_type="manual")
        monitor.set_club(ClubType.DRIVER)
        processed = self._processed_with_spin(
            SpinResult(
                spin_rpm=3296,
                confidence=0.8,
                snr=12.99,
                quality="high",
                peak_freq_hz=54.931640625,
                seam_cycles=3.9,
                at_lower_rail=True,
            )
        )

        shot = monitor._create_shot(processed)

        assert shot is not None
        assert shot.spin_rpm is None
        assert shot.spin_snr == pytest.approx(12.99)
        assert shot.spin_rejection_reason == (
            "Lower-rail spin candidate 3296 RPM kept as diagnostic only"
        )

    def test_low_quality_spin_withheld_from_shot_metrics(self):
        """Low-confidence rail spin should remain diagnostic, not user-facing."""
        from openflight.rolling_buffer import RollingBufferMonitor

        monitor = RollingBufferMonitor(port=None, trigger_type="manual")
        monitor.set_club(ClubType.DRIVER)
        processed = self._processed_with_spin(
            SpinResult(
                spin_rpm=3296,
                confidence=0.3,
                snr=2.88,
                quality="low",
                peak_freq_hz=54.931640625,
                seam_cycles=3.8,
                at_lower_rail=True,
            )
        )

        shot = monitor._create_shot(processed)

        assert shot is not None
        assert shot.spin_rpm is None
        assert shot.spin_snr == pytest.approx(2.88)
        assert shot.spin_peak_freq_hz == pytest.approx(54.931640625)
        assert shot.spin_rejection_reason == (
            "Lower-rail spin candidate 3296 RPM kept as diagnostic only"
        )

    def test_low_quality_non_rail_spin_remains_reportable(self):
        """Non-rail low-confidence spin can be shown but must not drive carry."""
        from openflight.rolling_buffer import RollingBufferMonitor

        monitor = RollingBufferMonitor(port=None, trigger_type="manual")
        monitor.set_club(ClubType.IRON_7)
        processed = self._processed_with_spin(
            SpinResult(
                spin_rpm=5493,
                confidence=0.3,
                snr=2.84,
                quality="low",
                peak_freq_hz=91.552734375,
                seam_cycles=4.1,
                at_lower_rail=False,
            )
        )

        shot = monitor._create_shot(processed)

        assert shot is not None
        assert shot.spin_rpm == 5493
        assert shot.spin_quality == "low"
        assert shot.spin_rejection_reason is None
        assert shot.carry_spin_adjusted is None

    def test_create_shot_uses_capture_trigger_epoch_for_impact_timestamp(self):
        """Rolling-buffer shots should carry the wall-clock sound trigger time."""
        from openflight.rolling_buffer import RollingBufferMonitor

        monitor = RollingBufferMonitor(port=None, trigger_type="manual")
        capture = IQCapture(
            sample_time=100.000,
            trigger_time=100.068,
            i_samples=[0] * 4096,
            q_samples=[0] * 4096,
            trigger_timestamp=1715000000.123,
        )
        processed = ProcessedCapture(
            timeline=SpeedTimeline(readings=[], sample_rate_hz=937.5, capture=capture),
            ball_speed_mph=100.0,
            ball_timestamp_ms=68.0,
            club_speed_mph=75.0,
            capture=capture,
        )

        shot = monitor._create_shot(processed)

        assert shot is not None
        assert shot.impact_timestamp == pytest.approx(1715000000.123)
        assert shot.impact_timestamp_kld7 == pytest.approx(1715000000.123)

    def test_create_shot_applies_ops_transition_impact_offset(self):
        """Transition impact timing should shift K-LD7 correlation per shot."""
        from openflight.rolling_buffer import RollingBufferMonitor

        monitor = RollingBufferMonitor(port=None, trigger_type="manual")
        capture = IQCapture(
            sample_time=100.000,
            trigger_time=100.068,
            i_samples=[0] * 4096,
            q_samples=[0] * 4096,
            trigger_timestamp=1715000000.123,
        )
        processed = ProcessedCapture(
            timeline=SpeedTimeline(readings=[], sample_rate_hz=937.5, capture=capture),
            ball_speed_mph=100.0,
            ball_timestamp_ms=68.0,
            club_speed_mph=75.0,
            capture=capture,
            impact=ImpactEstimate(
                timestamp_ms=60.0,
                source="ops_transition",
            ),
        )

        shot = monitor._create_shot(processed)

        assert shot is not None
        assert shot.impact_timestamp == pytest.approx(1715000000.123)
        assert shot.impact_timestamp_kld7 == pytest.approx(1715000000.115)


# =============================================================================
# Integration Tests
# =============================================================================
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
