JedS/openflight/(commit log)

2026-03-01 [cr] more camera params for testing
2026-03-02 [cr] disable camera on mock mode
2026-03-10 [cr] fix capture window
    [server.py]
2026-03-29 feat(kld7): add server CLI flags, init, and shot angle attachment
    - Add --kld7, --kld7-port, --kld7-orientation CLI flags to server and start-kiosk.sh
    - Add init_kld7() function and cleanup in server main()
    - Add K-LD7 as highest-priority angle source in on_shot_detected(), before camera
    - Add angle_source field to Shot dataclass ("radar", "camera", "estimated", or None)
    - Include angle_source in shot_to_dict() output
    - Camera angle detection now skipped when K-LD7 already provided vertical angle
    - Add tests for angle_source in shot_to_dict
    [server.py, test_server.py]
2026-04-02 experiment(kld7): add speed, angle spread, and duration filters to get_angle_for_shot
2026-04-02 experiment(kld7): add minimum magnitude and distance filters
2026-04-02 experiment(kld7): add min frame count and confidence threshold filters
2026-04-02 config: disable camera by default, K-LD7 radar handles angle
2026-04-02 Add files via upload
    Adding all files, project, and readme necessary for 3d printed case build
    [KLD7_h_mount_L.stl, KLD7_h_mount_R.stl, KLD7_v_mount_L.stl, KLD7_v_mount_R.stl, OPS_mount.stl, OpenFlight_case_proj.3mf, case_foot.stl, outer_case_bottom.stl]
2026-04-02 feat(kld7): rewrite signal processing — distance-based ball/club detection
    Ball detection: fast targets (>8 km/h) at far range (>3.8m) in 1-3 frame
    burst. Validated against real captures: wedge mean +26°, 7i mean +18°.
    Club detection: speed transition (slow→fast) at close range (1-2.5m).
    The club head approaching the ball creates an abrupt speed jump.
    Replaces the old magnitude-based filtering which couldn't distinguish
    ball from body clutter. The new approach uses the K-LD7's distance
    measurement to separate ball (far, fast burst) from body (close, slow,
    persistent) and club (close, speed transition).
    [test_kld7.py, tracker.py]
2026-04-06 [cr] scripts to start capturing raw ADC data from kld7
2026-04-06 feat: RADC phase-interferometry angle extraction with PDAT fallback
    [test_kld7.py, tracker.py]
2026-04-06 feat: pass ball speed to K-LD7 for RADC velocity filtering
2026-04-07 [cr] fix OPS max speed reporting
    [processor.py, tracker.py]
2026-04-09 removing old step files
    [KLD7_h_mount_L.step, KLD7_h_mount_R.step, KLD7_v_mount_L.step, KLD7_v_mount_R.step, OPS_mount.step, case_foot.step, outer_case_bottom.step, outer_case_top.step]
2026-04-12 feat: add physics-based ball flight simulator
    Adds `ballistics.py` with a deterministic drag + Magnus ODE simulator
    (RK4, 500 Hz) and a `resolve_launch()` helper that substitutes
    club-typical spin when measured spin confidence is below the "high"
    threshold. Output is a single committed trajectory — no probabilistic
    range — so it composes cleanly with future simulator handoffs.
    Aerodynamic model uses Hill-type Cl(Sp) and linear Cd(Sp) fits
    consistent with Bearman & Harvey (1976) and Kensrud & Smith (2018)
    for dimpled balls past the drag crisis. Spin decays exponentially
    at 4%/s per Kiratidis & Leinweber (2018).
    No UI or server changes — module is standalone. Tests cover
    launch-resolut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
2026-04-16 fix: tighten spin confidence scoring and add hard RPM ceiling
    Three changes to spin detection in processor.py:
    - Hard cap: reject spin > 12000 RPM (SPIN_MAX_SEAM_HZ * 60) as a
    safety net for the autocorrelation override path
    - Confidence rescoring: 0.7 now requires both SNR >= 5 AND (cycles >= 3
    or autocorrelation). Bare SNR >= 5 without cycle validation drops to
    0.5, below the ballistics "high" threshold
    - Modulation depth floor: < 1% modulation caps confidence at 0.5
    Addresses session 20260415 where 4/6 shots returned 2637 RPM at 0.7
    confidence (FFT bin locking) and one shot returned 20455 RPM.
    [processor.py, test_rolling_buffer.py]
2026-04-16 fix: add horizontal angle plausibility check in server (±15° max)
    Backstop guard for horizontal K-LD7 angles — rejects readings beyond
    ±15° before they reach the Shot object. The primary gate is in
    radc.py (extract_launch_angle), but this catches anything that
    bypasses it. Previously horizontal angles were accepted unconditionally.
    [server.py]
2026-04-20 feat(diagnose): OPS243 checks (connectivity, rolling buffer, software trigger)
    Adds 3 checks for the OPS243 radar:
    - Check 1: port detection + version query
    - Check 2: verify radar boots in rolling buffer mode (silent serial)
    - Check 3: software trigger returns valid 4096-sample capture
    Plus print_check_header/print_check_result helpers for live output.
    10 new tests.
2026-04-22 fix(kld7): increase ring buffer to 6s to survive OPS243 serial dump
    [server.py]
2026-05-04 [cr] fix radc script
    [capture_kld7_radc.py, serial_io.py, tracker.py]
2026-05-11 Filter KLD7 angle extraction by shot window
2026-05-11 Improve spin diagnostics and rail guardrails
2026-05-12 Drop spin autocorr override and lower SNR floor
    - Remove the autocorrelation override branch in detect_spin. The
    autocorr search-region peak commonly lands at minimum lag (~12000
    RPM, the upper rail) and was flipping legitimate mid-range FFT
    seam picks to the upper rail, where they then got rejected as
    bandpass-shoulder noise. The fallback now only confirms the FFT
    pick when the two agree within 10%; disagreements are logged for
    diagnostics but never replace the FFT result.
    - Lower SPIN_SNR_MIN from 3.0 to 2.5 so marginal but real seam tones
    are reported at low confidence instead of dropped.
    - Add scripts/analysis/plot_spin_debug.py: 4-panel diagnostic for one
    rolling_buffer_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
    [processor.py, test_rolling_buffer.py]
2026-05-12 Clean up radar processing flow
2026-05-14 [cr] dont reject geniunely low launch angles, low-confidence spin doesn't flow to UI
    [monitor.py, server.py, test_rolling_buffer.py, test_server.py]
2026-05-24 [cr] fix #89, larger window for kld7 buffer
    [monitor.py, ops243.py, processor.py, radc.py, server.py, test_kld7.py, test_kld7_radc_lib.py, test_rolling_buffer.py]
2026-05-27 [cr] fix stream error on kld7
    [serial_io.py, test_kld7.py]
2026-05-27 [cr] slightly throttle kld7 stream
2026-05-27 [cr] slightly throttle kld7 stream more
2026-05-27 [cr] fix shutdown path so everything cleans up
    [server.py, test_server.py]
2026-05-31 Add K-LD7 vertical launch-angle geometry analysis tooling
    Offline trajectory-fit estimators and validation scripts for K-LD7 vertical
    launch angle, no training data (physics/geometry only):
    - tvbin_tracker.py: time-varying-bin trajectory tracker, best estimator
    (~2.3 deg MAE, near-zero bias on confirmed-geometry 18deg sessions)
    - trajectory_fitter[_v2|_all_sessions].py, geom_vertical_selector[_v2].py,
    tier1_vertical_selector.py: earlier geometry approaches
    - ops_impact_finder.py: derive Pi impact timestamp from rolling buffer
    - calibrate_kld7_reflector.py: corner-reflector boresight calibration
    - geom_vs_naive / constant_vs_geom / geom_refine: validation that the
    trajectory geometry c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
2026-05-31 kld7: add vertical rule-stack frame selection and impact-time logging
